Pingu207/ROCKET/FW/README.md

## About the Code

This is untested code, mostly boilerplate for now with init functions, and the start sequence in app_main(). State machine and all other files for the other components have not been worked on and will be typed in when the board arrives and testing is possible.

## AI

Help was taken from AI in the review process of the code, mostly for fixing issues with formatting, clarity, and error handling.
