Pingu207/ROCKET/Hardware Bill of Materials template - Sheet1.csv

Item Name | Qty | Price (total) (USD) | Item link | Notes
AeroTech G25W-10A RMS-29/120 Reload Kit (1 Pack) - 072510 | 5 | $206.58 | https://aerotech-rocketry.com/products/product_c968e0dc-44a1-0a42-42dc-d69b16336291 | This is our rocket motor we will be using for our TVC
5.38" Airframe Tubing 34" | 1 | $68.38 | https://locprecision.com/collections/rocket-components/products/cardboard-airframes?variant=39778656190655 | This is the body we are using but on the CAD it is a little smaller but it will be scaled up when printed
Fiberon™ PA6-GF25 | 2 | $59.98 | https://shop.polymaker.com/products/fiberon-pa6-gf25?variant=43596329582649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
Hitec HS-5055MG 9g Digital Metal Gear Micro Servo | 2 | $65.97 | https://motionrc.com/products/hitec-hs-5055mg-9g-digital-metal-gear-micro-servo-hrc35055s?gad_source=1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 | This is the servo we will be using for the TVC
Estes 12 Inch Model Rocket Parachute Orange/White 1 pc | 1 | $7.41 | https://www.acehardware.com/departments/home-and-decor/novelty-items/toys-and-games/9093761 | This will be the drouge parachute that comes out before the real one
Rip Stop Parachute | 1 | $20.92 | https://estesrockets.com/products/rip-stop-parachute?variant=51539308020017&country=US&currency=USD | This will be the main parachute
Total Price (USD): | $429.24
