Pingu207/ROCKET/PCB/electricalBOM.csv

JLCPCB BOM Tool - BOM Matching
BOM name：bom-JLCPCB Assembly Order.xlsx |  |  | Download Time：2026-10-25 23:32:35 |  |  |  | * Our matching results are updated in real-time, but stock and prices may change. If it's been over 24 hours, please re-match before placing your order.
PCB Assembled Qty：5 |  |  | Est. Total Price：278.1183
Your BOM |  |  |  | Matched Parts |  |  |  |  |  |  | Order Information
Designator | Comment | Footprint | JLCPCB Part # | Matches | Part # | Manufacturer | Footprint | Description | Category | Warning | JLCPCB Part # | Product link | Lib Type | Qty | Source | Total Price ($)
BZ1 | Buzzer | BUZ-TH_BD9.0-P4.00-D0.6-FD |  | Select by System | QMB-09B-03 | Jiangsu Huaneng Elec | 插件,D=9mm | -20℃~+70℃ 2.7kHz 2V~5V 3V 5.7mm 50mA 85dB 9mm Electromagnetic Passive (Externally Driven) 插件,D=9mm Buzzers ROHS | Buzzers |  | C96256 | https://jlcpcb.com/partdetail/Jiangsu_HuanengElec-QMB_09B03/C96256 | Extended | 6 | 6 JLCPCB | 0.708
C1,C12,C18,C23,C24,C26,C28,C3,C30,C33,C34,C35,C4,C5,C6,C8,C9 | 0.1uF | C0603 |  | Select by System | CT41G-0603-2X1-50V-0.1uF-K(N) | TORCH | 603 | 100nF 50V ±10% 0603 Multilayer Ceramic Capacitors MLCC - SMD/SMT ROHS | Multilayer Ceramic Capacitors MLCC - SMD/SMT |  | C125205 | https://jlcpcb.com/partdetail/TORCH-CT41G_0603_2X1_50V_0_1uF_K_N/C125205 | Extended | 91 | 91 JLCPCB | 0.9919
C10,C11,C16,C17,C2,C27,C29 | 10uF | C0805 |  | Select by System | GRM21BR61H106KE43L | Murata Electronics | 805 | 10uF 50V X5R ±10% 0805 Multilayer Ceramic Capacitors MLCC - SMD/SMT ROHS | Multilayer Ceramic Capacitors MLCC - SMD/SMT |  | C440198 | https://jlcpcb.com/partdetail/439567-GRM21BR61H106KE43L/C440198 | Basic | 37 | 37 JLCPCB | 7.6923
C13,C14,C15,C19,C20,C21,C31,C32 | 22uF | C0805 |  | Select by System | GRM21BR61E226ME44L | Murata Electronics | 805 | 22uF 25V X5R ±20% 0805 Multilayer Ceramic Capacitors MLCC - SMD/SMT ROHS | Multilayer Ceramic Capacitors MLCC - SMD/SMT |  | C86816 | https://jlcpcb.com/partdetail/MurataElectronics-GRM21BR61E226ME44L/C86816 | Extended | 44 | 44 JLCPCB | 10.5644
C22,C7 | 470uF | CAP-SMD_BD10.0-L10.3-W10.3-FD |  | Select by System | RVT1V471M1010 470UF 35V | DMBJ | SMD,D10xL10.2mm | -55℃~+105℃ 10.2mm 10mm 2800hrs@105℃ 35V 470uF ±20% SMD,D10xL10.2mm Aluminum Electrolytic Capacitors - SMD ROHS | Aluminum Electrolytic Capacitors - SMD |  | C976030 | https://jlcpcb.com/partdetail/DMBJ-RVT1V471M1010_470UF35V/C976030 | Extended | 10 | 10 JLCPCB | 0.909
D1,D2 | M7 | SMA_L4.3-W2.6-LS5.2-RD |  | Select by System | M7 | MDD(Microdiode Semiconductor) | SMA(DO-214AC) | -55℃~+150℃ 1.1V@1A 1A 1kV 30A 5uA@1kV Independent SMA(DO-214AC) Diodes - General Purpose ROHS | Diodes - General Purpose |  | C95872 | https://jlcpcb.com/partdetail/MDD_Microdiode_Semiconductor-M7/C95872 | Basic | 20 | 20 JLCPCB | 0.206
D3,D4,D5 | LED_Small | LED0603-FD |  | Select by System | YLED0603R | YONGYUTAI | 603 | -40℃~+85℃ 1.8V~2.4V 120mcd 120° 25mA 620nm~625nm Discrete Diode Red 0603 LED Indication - Discrete ROHS | LED Indication - Discrete |  | C19171390 | https://jlcpcb.com/partdetail/YONGYUTAI-YLED0603R/C19171390 | Extended | 31 | 31 JLCPCB | 0.1953
D6,D7 | D_Schottky_Small | SMC_L6.9-W5.9-LS7.9-RD |  | Unconfirmed | SS34 | onsemi | SMC(DO-214AB) | -55℃~+150℃ 1 Independent 100A 3A 40V 500mV@3A 500uA@40V SMC(DO-214AB) Schottky Diodes ROHS | Schottky Diodes | 1.Multiple lines in the BOM have been matched to the same part. Please check if the matching is correct. ; | C154551 | https://jlcpcb.com/partdetail/onsemi-SS34/C154551 | Extended | 15 | 15 JLCPCB | 7.1445
D8 | SS34 | SMC_L6.9-W5.9-LS7.9-RD |  | Unconfirmed
J1 | USB_C_Receptacle_USB2.0_14P | USB-C-TH_KH-TYPE-C-CY-14P |  | Select by System | KH-TYPE-C-CY-14P | Shenzhen Kinghelm Elec | 插件 | -40℃~+85℃ 1 10,000 cycles 14P 14mm 20V 3A Black Female Type-C Vertical, Flag 插件 USB Connectors ROHS | USB Connectors |  | C2919655 | https://jlcpcb.com/partdetail/3222637-KH_TYPE_C_CY14P/C2919655 | Extended | 5 | 5 JLCPCB | 2.7575
J2,J3,J4 | Conn_01x02_Socket | CONN-TH_2P-P2.00_HC-PH-2A-M |  | Select by System | WAFER-PH2.0-2PZZ | XUNPU | 插件,P=2mm | -25℃~+85℃ 1 1x2P 2 250V 2A 2P 2mm 4.7mm 6.05mm 6mm Brass PA66 PH Through Hole Tin UL94V-0 White 插件,P=2mm Wire To Board Connector ROHS | Wire To Board Connector |  | C5359599 | https://jlcpcb.com/partdetail/XUNPU-WAFER_PH2_02PZZ/C5359599 | Extended | 20 | 20 JLCPCB | 0.278
J5,J6 | Screw_Term_1x2 | CONN-TH_XY126V-5.0-2P |  | Select by System | XY126V-5.0-2P | Ningbo Xinlaiya Elec. | 插件,P=5mm | 1 10A 14~26 1x2P 2 2.5 2P 300V 5mm Green M2.5 Through Hole 插件,P=5mm Screw Terminal Blocks ROHS | Screw Terminal Blocks |  | C557646 | https://jlcpcb.com/partdetail/Ningbo_Xinlaiya_Elec-XY126V_5_02P/C557646 | Extended | 11 | 11 JLCPCB | 1.0659
J7 | Micro_SD_Card | TF-SMD_TF-115 |  | Select by System | TF-115 | XUNPU | SMD | 1.8mm Connector and Ejector MicroSD Card (TF Card) Push-Push SMD SD Card / Memory Card Connector ROHS | SD Card / Memory Card Connector |  | C266620 | https://jlcpcb.com/partdetail/XUNPU-TF115/C266620 | Extended | 6 | 6 JLCPCB | 1.0452
J8 | Conn_02x03_Odd_Even | HDR-TH_6P-P2.54-V-R2-C3-S2.54_A2541WV-2X3P |  | Select by System | 2.54-2*3 | ZHOURI | 插件,P=2.54mm | -40℃~+105℃ 2 2.54mm 2.54mm 2.54mm 2.5A 2x3P 3mm 6P 6mm Brass Gold Pin Header Through Hole 插件,P=2.54mm Pin Headers ROHS | Pin Headers |  | C5116479 | https://jlcpcb.com/partdetail/ZHOURI-2_54_23/C5116479 | Extended | 5 | 5 JLCPCB | 0.2995
L1,L2 | 3.3uH | IND-SMD_L4.4-W4.2-A |  | Select by System | FXL0420-3R3-M | cjiang (Changjiang Microelectronics Tech) | SMD,4.4x4.2mm | 3.3A 3.3uH 4A 87mΩ Molded inductor ±20% SMD,4.4x4.2mm Molding Power Inductors ROHS | Power Inductors |  | C167207 | https://jlcpcb.com/partdetail/178590-FXL0420_3R3M/C167207 | Extended | 12 | 12 JLCPCB | 1.6896
L3 | 3.9uH | IND-SMD_L5.0-W5.0 |  | Select by System | ZENR5040T3R9N-3.9uH | ZE | SMD,5x5mm | 27mΩ 3.2A 3.55A 3.9uH Magnetic Shielded Inductor ±30% SMD,5x5mm Power Inductors ROHS |  |  | C42428060 | https://jlcpcb.com/partdetail/ZE-ZENR5040T3R9N_39uH/C42428060 | Extended | 7 | 7 JLCPCB | 0.4424
Q1,Q2 | Q_NPN | SOT-23-3_L3.0-W1.7-P0.95-LS2.9-BR |  | Select by System | S8050 J3Y(RANGE:200-350) | Jiangsu Changjing Electronics Technology Co., Ltd. | SOT-23 | -55℃~+150℃ 1 NPN 100nA 150MHz 200 25V 300mW 500mA 5V 600mV NPN SOT-23 Bipolar (BJT) ROHS | Bipolar (BJT) |  | C2146 | https://jlcpcb.com/partdetail/2503-S8050_J3Y_RANGE_200_350/C2146 | Basic | 15 | 15 JLCPCB | 0.213
Q3,Q5 | IRLZ44N | TO-220-3_L10.0-W4.5-P2.54-T |  | Select by System | IRLZ44NPBF | Infineon Technologies | TO-220AB | -55℃~+175℃ 1 N-channel 1.7nF 110W 150pF 25mΩ@5V 2V 400pF 47A 48nC@5V 55V N-Channel TO-220AB MOSFETs ROHS | MOSFETs |  | C38774 | https://jlcpcb.com/partdetail/InfineonTechnologies-IRLZ44NPBF/C38774 | Extended | 10 | 10 JLCPCB | 7.185
Q4 | IRF7404 | SOIC-8_L4.9-W3.9-P1.27-LS6.0-BL |  | Select by System | IRF7404TRPBF | Infineon Technologies | SO-8 | -55℃~+150℃ 1 P-Channel 1.5nF 2.5W 20V 340pF 40mΩ@4.5V 50nC@4.5V 6.7A 700mV 730pF P-Channel SO-8 MOSFETs ROHS | MOSFETs |  | C2997 | https://jlcpcb.com/partdetail/InfineonTechnologies-IRF7404TRPBF/C2997 | Extended | 5 | 5 JLCPCB | 10.1055
Q6 | PN2222A | TO-92-3_L4.9-W3.7-P1.27-L |  | Select by System | 2N2222A | ST(Semtech) | TO-92 | 1 NPN 10nA 1V 250MHz 40 40V 600mA 625mW 6V NPN TO-92 Bipolar (BJT) ROHS | Bipolar (BJT) |  | C118536 | https://jlcpcb.com/partdetail/ST_Semtech-2N2222A/C118536 | Extended | 8 | 8 JLCPCB | 0.312
R1,R11,R15,R17,R19,R2,R20,R21,R27,R28,R3,R34,R35,R39,R40,R41,R8,R9 | 10k | R0603 |  | Select by System | RC0603FR-0710KL | YAGEO | 603 | -55℃~+155℃ 100mW 10kΩ 75V Thick Film Resistor ±1% ±100ppm/℃ 0603 Chip Resistor - Surface Mount ROHS | Chip Resistor - Surface Mount |  | C98220 | https://jlcpcb.com/partdetail/YAGEO-RC0603FR0710KL/C98220 | Extended | 100 | 100 JLCPCB | 0.27
R4 | 1k | R0603 |  | Select by System | RC0603FR-071KL | YAGEO | 603 | -55℃~+155℃ 100mW 1kΩ 75V Thick Film Resistor ±1% ±100ppm/℃ 0603 Chip Resistor - Surface Mount ROHS | Chip Resistor - Surface Mount |  | C22548 | https://jlcpcb.com/partdetail/YAGEO-RC0603FR071KL/C22548 | Extended | 20 | 20 JLCPCB | 0.072
R6,R7 | 5.1k | R0603 |  | Select by System | FRC0603F5101TS | FOJAN | 603 | -55℃~+155℃ 100mW 5.1kΩ 75V Thick Film Resistor ±1% ±100ppm/℃ 0603 Chip Resistor - Surface Mount ROHS | Chip Resistor - Surface Mount |  | C2907044 | https://jlcpcb.com/partdetail/FOJAN-FRC0603F5101TS/C2907044 | Extended | 20 | 20 JLCPCB | 0.038
R10,R14 | 100 | R0603 |  | Select by System | 0603WAF1000T5E | UNI-ROYAL(Uniroyal Elec) | 603 | -55℃~+155℃ 100mW 100Ω 75V Thick Film Resistor ±1% ±100ppm/℃ 0603 Chip Resistor - Surface Mount ROHS | Chip Resistor - Surface Mount |  | C22775 | https://jlcpcb.com/partdetail/23502-0603WAF1000T5E/C22775 | Basic | 20 | 20 JLCPCB | 0.046
R12,R13,R26,R30,R32,R33 | 4.7k | R0603 |  | Select by System | RC0603FR-074K7L | YAGEO | 603 | -55℃~+155℃ 100mW 4.7kΩ 75V Thick Film Resistor ±1% ±100ppm/℃ 0603 Chip Resistor - Surface Mount ROHS | Chip Resistor - Surface Mount |  | C99782 | https://jlcpcb.com/partdetail/YAGEO-RC0603FR074K7L/C99782 | Extended | 40 | 40 JLCPCB | 0.128
R16,R18 | 68.1k | R0603 |  | Select by System | 0603WAF6812T5E | UNI-ROYAL(Uniroyal Elec) | 603 | -55℃~+155℃ 100mW 68.1kΩ 75V Thick Film Resistor ±1% ±100ppm/℃ 0603 Chip Resistor - Surface Mount ROHS | Chip Resistor - Surface Mount |  | C25976 | https://jlcpcb.com/partdetail/26719-0603WAF6812T5E/C25976 | Extended | 20 | 20 JLCPCB | 0.04
R22,R23,R24,R25 | 150 | R0603 |  | Select by System | FRC0603F1500TS | FOJAN | 603 | -55℃~+155℃ 100mW 150Ω 75V Thick Film Resistor ±1% ±100ppm/℃ 0603 Chip Resistor - Surface Mount ROHS | Chip Resistor - Surface Mount |  | C2906994 | https://jlcpcb.com/partdetail/FOJAN-FRC0603F1500TS/C2906994 | Extended | 30 | 30 JLCPCB | 0.057
R31,R5 | 470 | R0603 |  | Select by System | 0603WAF4700T5E | UNI-ROYAL(Uniroyal Elec) | 603 | -55℃~+155℃ 100mW 470Ω 75V Thick Film Resistor ±1% ±100ppm/℃ 0603 Chip Resistor - Surface Mount ROHS | Chip Resistor - Surface Mount |  | C23179 | https://jlcpcb.com/partdetail/23906-0603WAF4700T5E/C23179 | Basic | 20 | 20 JLCPCB | 0.046
R36 | 33k | R0603 |  | Select by System | FRC0603F3302TS | FOJAN | 603 | -55℃~+155℃ 100mW 33kΩ 75V Thick Film Resistor ±1% ±100ppm/℃ 0603 Chip Resistor - Surface Mount ROHS | Chip Resistor - Surface Mount |  | C2907028 | https://jlcpcb.com/partdetail/FOJAN-FRC0603F3302TS/C2907028 | Extended | 20 | 20 JLCPCB | 0.04
R37 | 100k | R0603 |  | Select by System | RC0603FR-07100KL | YAGEO | 603 | -55℃~+155℃ 100kΩ 100mW 75V Thick Film Resistor ±1% ±100ppm/℃ 0603 Chip Resistor - Surface Mount ROHS | Chip Resistor - Surface Mount |  | C14675 | https://jlcpcb.com/partdetail/YAGEO-RC0603FR07100KL/C14675 | Extended | 20 | 20 JLCPCB | 0.046
R38 | 0 | R0603 |  | Select by System | RC0603JR-070RL | YAGEO | 603 | -55℃~+155℃ 0Ω 100mW 75V Thick Film Resistor ±5% 0603 Chip Resistor - Surface Mount ROHS | Chip Resistor - Surface Mount |  | C95177 | https://jlcpcb.com/partdetail/YAGEO-RC0603JR070RL/C95177 | Extended | 20 | 20 JLCPCB | 0.042
R42 | 330 | R0603 |  | Select by System | RC0603FR-07330RL | YAGEO | 603 | -55℃~+155℃ 100mW 330Ω 75V Thick Film Resistor ±1% ±100ppm/℃ 0603 Chip Resistor - Surface Mount ROHS | Chip Resistor - Surface Mount |  | C105881 | https://jlcpcb.com/partdetail/YAGEO-RC0603FR07330RL/C105881 | Extended | 20 | 20 JLCPCB | 0.09
SW1,SW2 | Tactile | SW-SMD_L3.9-W3.0-P4.45 |  | Select by System | TS-1088-AR02016 | XUNPU | SMD,4x3mm | -30℃~+80℃ 1.6N 100,000 cycles 12V 2mm 3.9mm 3mm 50mA Black Round Button SMD(SMT) Tab SPST Surface Mount,Vertical Without Bracket SMD,4x3mm Tactile Switches ROHS | Tactile Switches |  | C720477 | https://jlcpcb.com/partdetail/XUNPU-TS_1088AR02016/C720477 | Basic | 14 | 14 JLCPCB | 0.7378
U1 | ESPWROOM32 | WIFIM-SMD_ESP32-WROOM-32-N4 |  | Select by System | ESP32-WROOM-32-N4 | Espressif Systems | SMD,25.5x18mm | -40℃~+85℃ -98dBm 2.4GHz 2.7V~3.6V 20dBm Bluetooth4.2 ESP32-DOWDQ6 UART、SDIO、SPI、I2C、GPIO、PWM、ADC、DAC SMD,25.5x18mm WiFi Modules ROHS | WiFi Modules |  | C82899 | https://jlcpcb.com/partdetail/EspressifSystems-ESP32_WROOM_32N4/C82899 | Extended | 5 | 5 JLCPCB | 22.289
U2 | ICM-42688-P | LGA-14_L3.0-W2.5-P0.50-TL |  | Select by System | ICM-42688-P | TDK InvenSense | LGA-14(2.5x3) | -40℃~+85℃ 1.71V~3.6V 16bit 2KB 7.5uA IMU (accelerometer + gyroscope) SPI、I2C X,Y,Z X,Y,Z ±16g ±2000dps Motion Event Detection, Synchronization, Timestamp Support LGA-14(2.5x3) Accelerometers ROHS | Accelerometers |  | C1850418 | https://jlcpcb.com/partdetail/TDKInvenSense-ICM_42688P/C1850418 | Extended | 5 | 5 JLCPCB | 107.6485
U3 | CH340K | ESOP-10_L4.9-W3.9-P1.00-LS6.2-BL-EP |  | Select by Customer | CH340K | WCH(Jiangsu Qin Heng) | ESSOP-10-150mil-1mm | -20℃~+70℃ 2Mbps 3.3V、5V USB 2.0 USB to serial ESSOP-10-150mil-1mm USB Converters ROHS | USB Converters |  | C18208922 | https://jlcpcb.com/partdetail/WCH_Jiangsu_Qin_Heng-CH340K/C18208922 | Extended | 5 | 5 JLCPCB | 3.314
U4 | USBLC6-2SC6 | SOT-23-6_L2.9-W1.6-P0.95-LS2.8-BL |  | Select by System | USBLC6-2SC6 | STMicroelectronics | SOT-23-6L | -40℃~+125℃ 150nA 17V 2 3.5pF 5.25V 5A 6V ESD IEC 61000-4-2 Unidirectional SOT-23-6L ESD and Surge Protection (TVS/ESD) ROHS | ESD And Surge Protection (TVS/ESD) |  | C7519 | https://jlcpcb.com/partdetail/STMicroelectronics-USBLC62SC6/C7519 | Extended | 7 | 7 JLCPCB | 1.2579
U6 | AP63203WU | TSOT-26_L2.9-W1.6-P0.95-LS2.8-BL |  | Select by System | AP63203WU-7 | Diodes Incorporated | TSOT-23-6 | -40℃~+85℃@(TA) 1 1.1MHz 22uA 2A 3.3V 3.8V~32V Buck Built-in Fixed Overcurrent Protection、Light load efficient mode、Cycle-by-cycle current limiting、Hiccup current limiting、EMI optimization (spread spectrum) Step-down type Yes TSOT-23-6 DC-DC Converters ROHS | DC-DC Converters |  | C780769 | https://jlcpcb.com/partdetail/DiodesIncorporated-AP63203WU7/C780769 | Extended | 5 | 5 JLCPCB | 6.1205
U7,U8 | PC817 | DIP-4_L6.4-W4.6-P2.54-LS7.6-BL |  | Select by System | PC817X2NSZW | Sharp Microelectronics | DIP-4 | -30℃~+100℃ 1.2V 100mV@20mA,1mA 200mW 3us 4us 50mA 50mA 5kV 6V 80V DC DIP-4 Transistor, Photovoltaic Output Optoisolators ROHS | Transistor, Photovoltaic Output Optoisolators |  | C5350 | https://jlcpcb.com/partdetail/SharpMicroelectronics-PC817X2NSZW/C5350 | Extended | 11 | 11 JLCPCB | 0.8591
U10,U9 | TPS563200 | TSOT-26_L2.9-W1.6-P0.95-LS2.8-BL |  | Select by System | TPS563200DDCR | Texas Instruments | TSOT-23-6 | -40℃~+85℃@(TA) 1 3A 4.5V~17V 650kHz 760mV~7V Adjustable Buck Buck Built-in Yes TSOT-23-6 DC-DC Converters ROHS | DC-DC Converters |  | C97253 | https://jlcpcb.com/partdetail/TexasInstruments-TPS563200DDCR/C97253 | Extended | 10 | 10 JLCPCB | 8.739
U5 | BMP280 | LGA-8_L2.5-W2.0-P0.65_AMP6127 |  | Select by System | BMP280 | Bosch Sensortec | LGA-8 | -40℃~+85℃ 0.12hpa 1.5pa/K 1.71V~3.6V 1hpa 300nA 30Kpa~1.1bar I2C、SPI LGA-8(2x2.5) Pressure Sensors ROHS | Pressure Sensors |  | C83291 | https://jlcpcb.com/partdetail/BoschSensortec-BMP280/C83291 | Extended | 5 | 5 JLCPCB | 65.288
TOTAL PARTS COST |  | >>> | >>> | >>> | >>> | >>> | >>> | >>> | >>> | >>> | >>> | >>> | >>> | >>> | >>> | $270.97
Other | PCB Cost | >>> | >>> | >>> | >>> | >>> | >>> | >>> | >>> | >>> | >>> | >>> | >>> | >>> | >>> | $8.00
Other | PCBA Cost | >>> | >>> | >>> | >>> | >>> | >>> | >>> | >>> | >>> | >>> | >>> | >>> | >>> | >>> | $37.97
TOTAL OTHERS COST |  | >>> | >>> | >>> | >>> | >>> | >>> | >>> | >>> | >>> | >>> | >>> | >>> | >>> | >>> | $45.97
Total Cost | >>> | >>> | >>> | >>> | >>> | >>> | >>> | >>> | >>> | >>> | >>> | >>> | >>> | >>> | >>> | $316.94
