Pingu207/ROCKET/CAD/CONE.step

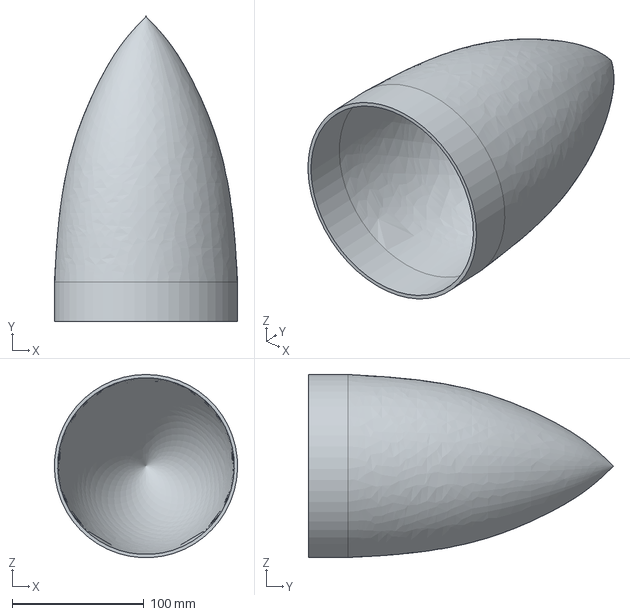
[picture p1: CAD file, 2026-10-26]
CAD/CONE.step
138.9 x 231.4 x 138.9 mm
