Pingu207/ROCKET/CAD/PCB_HOLDER.step

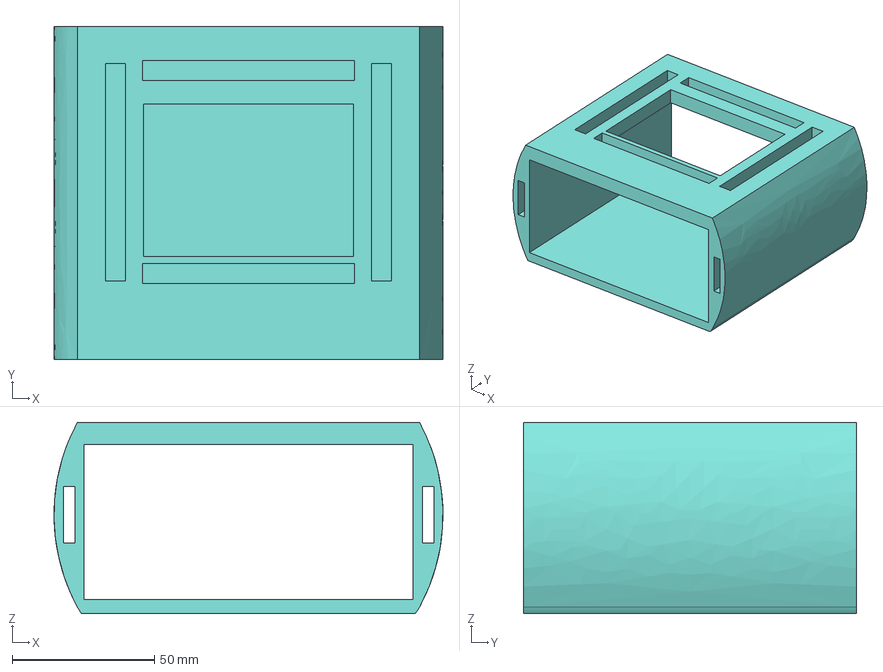
[picture p2: CAD file, 2026-10-26]
CAD/PCB_HOLDER.step
136.7 x 117.0 x 67.1 mm
