Pingu207/ROCKET/CAD/ROCKET_BODY.step

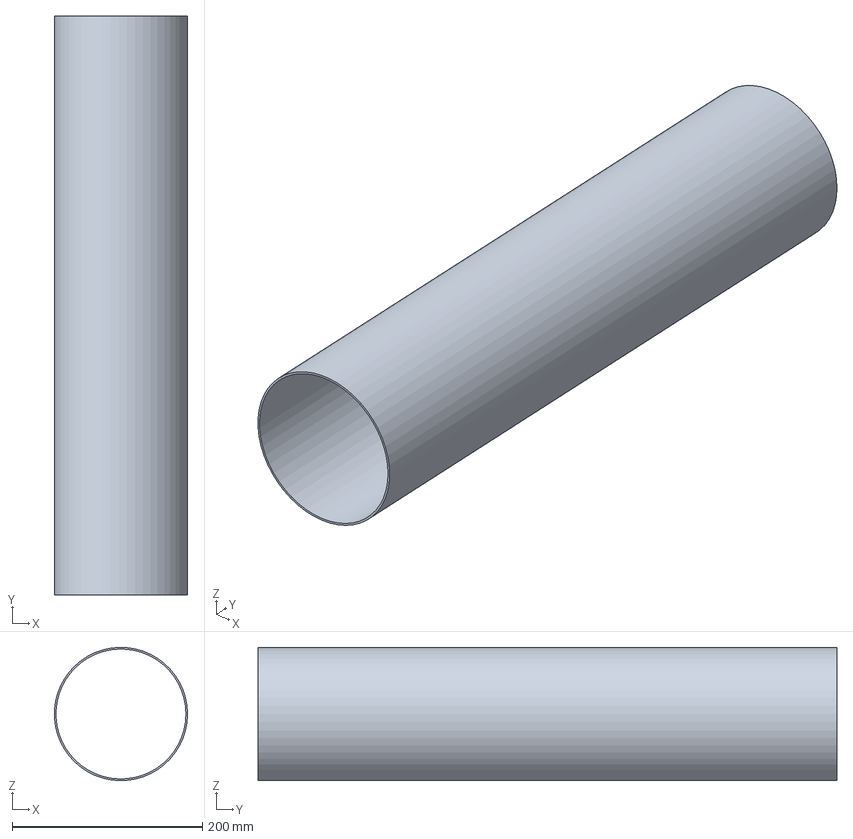
[picture p3: CAD file, 2026-10-26]
CAD/ROCKET_BODY.step
140.0 x 609.0 x 140.1 mm
