Pingu207/ROCKET/CAD/TVC_MOUNT.step

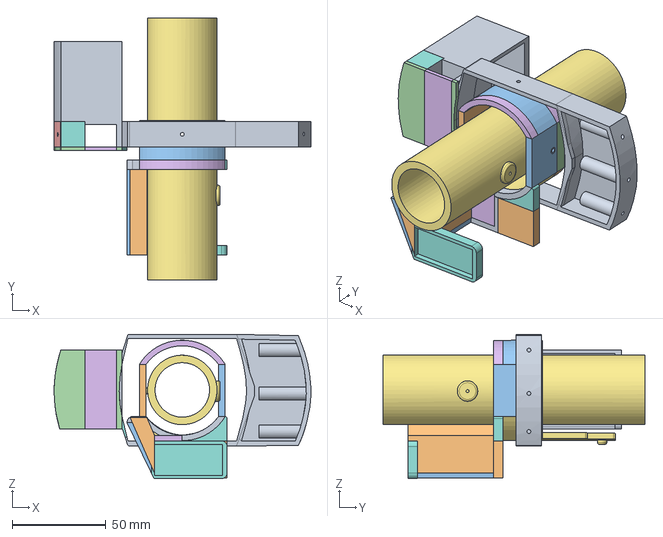
[picture p4: CAD file, 2026-10-26]
CAD/TVC_MOUNT.step
136.9 x 139.5 x 76.8 mm
