Pingu207/ROCKET/PCB/Rocket.kicad_pcb

## KiCad design PCB/Rocket.kicad_pcb (2026-10-25)

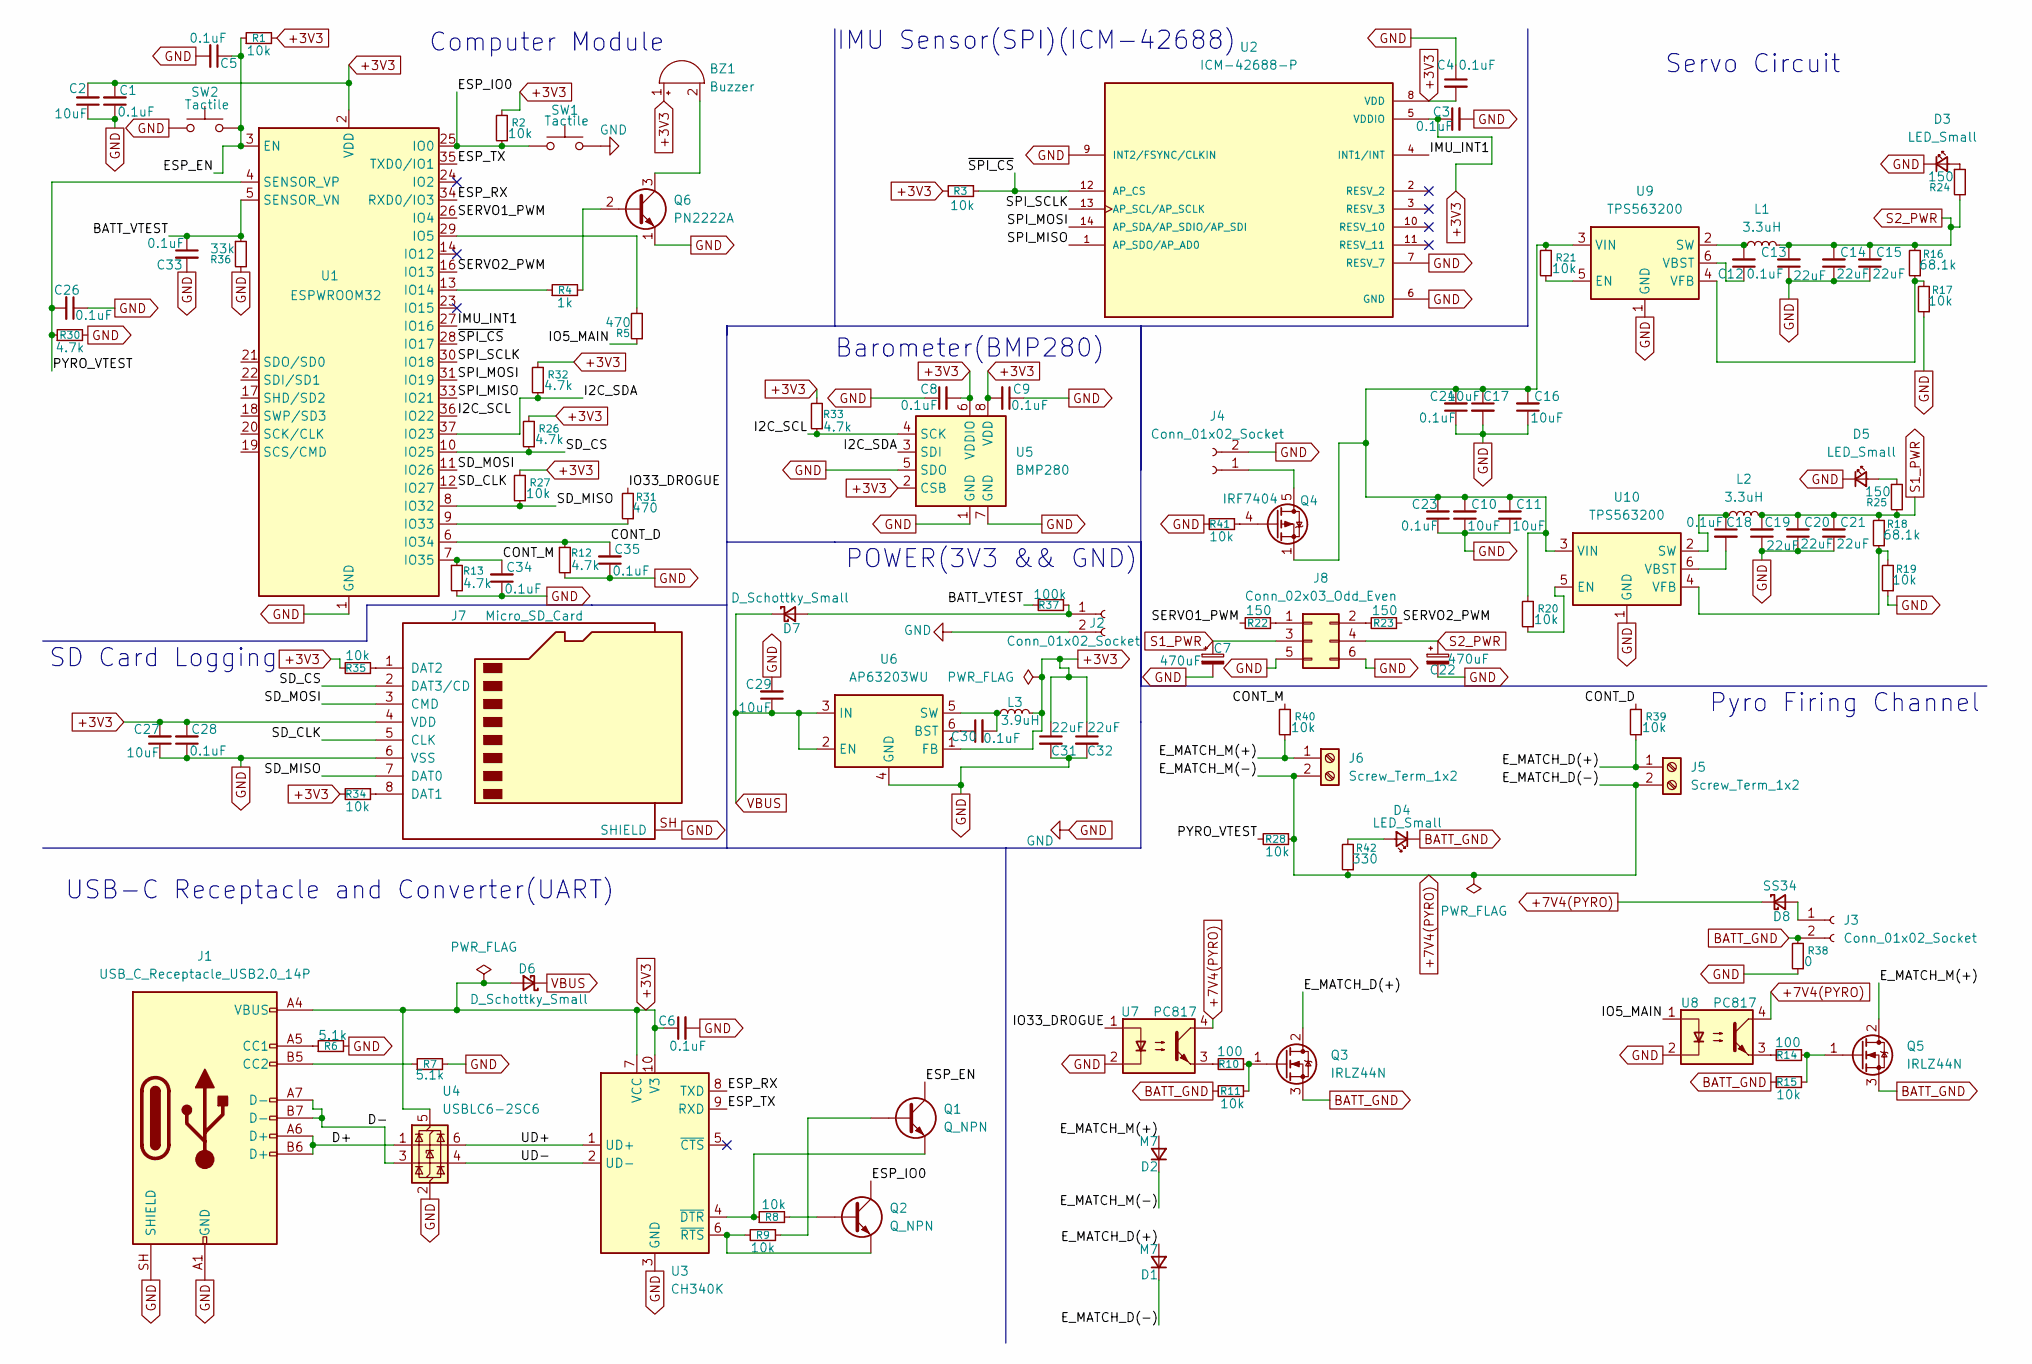
[picture p5: schematic Rocket.kicad_sch, Flight Computer for TVC Rocket Schematic]

Parts:
BZ1: Buzzer; BUZ-TH_BD9.0-P4.00-D0.6-FD; LCSC C96256
C1, C3, C4, C5, C6, C8, C9, C12, C18, C23, C24, C26, C28, C30, C33, C34, C35: 0.1uF; C0603; LCSC C125205
C2, C10, C11, C16, C17, C27, C29: 10uF; C0805; LCSC C440198
C7, C22: 470uF; CAP-SMD_BD10.0-L10.3-W10.3-FD; LCSC C976030
C13, C14, C15, C19, C20, C21, C31, C32: 22uF; C0805; LCSC C86816
D1, D2: M7; SMA_L4.3-W2.6-LS5.2-RD; LCSC C95872
D3, D4, D5: LED_Small; LED0603-FD; LCSC C19171390
D6, D7: D_Schottky_Small; SMC_L6.9-W5.9-LS7.9-RD; LCSC C154551
D8: SS34; SMC_L6.9-W5.9-LS7.9-RD; LCSC C154551
J1: USB_C_Receptacle_USB2.0_14P; USB-C-TH_KH-TYPE-C-CY-14P; LCSC C2919655
J2, J3, J4: Conn_01x02_Socket; CONN-TH_2P-P2.00_HC-PH-2A-M; LCSC C5359599
J5, J6: Screw_Term_1x2; CONN-TH_XY126V-5.0-2P; LCSC C557646
J7: Micro_SD_Card; TF-SMD_TF-115; LCSC C266620
J8: Conn_02x03_Odd_Even; HDR-TH_6P-P2.54-V-R2-C3-S2.54_A2541WV-2X3P; LCSC C5116479
L1, L2: 3.3uH; IND-SMD_L4.4-W4.2-A; LCSC C167207
L3: 3.9uH; IND-SMD_L5.0-W5.0; LCSC C42428060
Q1, Q2: Q_NPN; SOT-23-3_L3.0-W1.7-P0.95-LS2.9-BR; LCSC C2146
Q3, Q5: IRLZ44N; TO-220-3_L10.0-W4.5-P2.54-T; LCSC C38774
Q4: IRF7404; SOIC-8_L4.9-W3.9-P1.27-LS6.0-BL; LCSC C2997
Q6: PN2222A; TO-92-3_L4.9-W3.7-P1.27-L; LCSC C118536
R1, R2, R3, R8, R9, R11, R15, R17, R19, R20, R21, R27, R28, R34, R35, R39, R40, R41: 10k; R0603; LCSC C98220
R4: 1k; R0603; LCSC C22548
R5, R31: 470; R0603; LCSC C23179
R6, R7: 5.1k; R0603; LCSC C2907044
R10, R14: 100; R0603; LCSC C22775
R12, R13, R26, R30, R32, R33: 4.7k; R0603; LCSC C99782
R16, R18: 68.1k; R0603; LCSC C25976
R22, R23, R24, R25: 150; R0603; LCSC C2906994
R36: 33k; R0603; LCSC C2907028
R37: 100k; R0603; LCSC C14675
R38: 0; R0603; LCSC C95177
R42: 330; R0603; LCSC C105881
SW1, SW2: Tactile; SW-SMD_L3.9-W3.0-P4.45; LCSC C720477
U1: ESPWROOM32; WIFIM-SMD_ESP32-WROOM-32-N4; LCSC C82899
U2: ICM-42688-P; LGA-14_L3.0-W2.5-P0.50-TL; PARTREV 1.2; LCSC C1850418
U3: CH340K; ESOP-10_L4.9-W3.9-P1.00-LS6.2-BL-EP; LCSC C968586
U4: USBLC6-2SC6; SOT-23-6_L2.9-W1.6-P0.95-LS2.8-BL; LCSC C7519
U5: BMP280; LGA-8_L2.5-W2.0-P0.65_AMP6127; LCSC C83291
U6: AP63203WU; TSOT-26_L2.9-W1.6-P0.95-LS2.8-BL; LCSC C780769
U7, U8: PC817; DIP-4_L6.4-W4.6-P2.54-LS7.6-BL; LCSC C5350
U9, U10: TPS563200; TSOT-26_L2.9-W1.6-P0.95-LS2.8-BL; LCSC C97253

Connections:
+3V3: BZ1.1 (+), C1.2, C2.2, C3.1, C4.2, C6.1, C8.2, C9.2, C27.2, C28.2, C31.1, C32.1, D6.2 (A), J1.A4 (VBUS), J1.A9 (VBUS), J1.B4 (VBUS), J1.B9 (VBUS), J7.4 (VDD), L3.2, R1.2, R2.2, R3.2, R26.2, R27.2, R32.2, R33.2, R34.2, R35.2, U1.2 (VDD), U2.5 (VDDIO), U2.8 (VDD), U3.7 (VCC), U3.10 (V3), U4.5 (VBUS), U5.2 (CSB), U5.6 (VDDIO), U5.8 (VDD), U6.1 (FB)
+7V4(PYRO): D1.1 (K), D2.1 (K), D8.1 (K), J5.2, J6.2, R28.1, R42.1, U7.4, U8.4
/BATT_VTEST: C33.1, R36.1, R37.2, U1.5 (SENSOR_VN)
/CONT_D: C35.2, R12.1, R39.2, U1.6 (IO34)
/CONT_M: C34.2, R13.1, R40.2, U1.7 (IO35)
/D+: J1.A6 (D+), J1.B6 (D+), U4.1 (I/O1)
/D-: J1.A7 (D-), J1.B7 (D-), U4.3 (I/O2)
/ESP_EN: C5.1, Q1.3, R1.1, SW2.2, U1.3 (EN)
/ESP_IO0: Q2.3, R2.1, SW1.1, U1.25 (IO0)
/ESP_RX: U1.34 (RXD0/IO3), U3.8 (TXD)
/ESP_TX: U1.35 (TXD0/IO1), U3.9 (RXD)
/E_MATCH_D(+): D1.2 (A), J5.1, Q3.2 (D), R39.1
/E_MATCH_M(+): D2.2 (A), J6.1, Q5.2 (D), R40.1
/I2C_SCL: R33.1, U1.36 (IO22), U5.4 (SCK)
/I2C_SDA: R32.1, U1.37 (IO23), U5.3 (SDI)
/IMU_INT1: U1.27 (IO16), U2.4 (INT1/INT)
/IO5_MAIN: R5.1, U8.1
/IO33_DROGUE: R31.2, U7.1
/PYRO_VTEST: C26.2, R28.2, R30.1, U1.4 (SENSOR_VP)
/SD_CLK: J7.5 (CLK), U1.12 (IO27)
/SD_CS: J7.2 (DAT3/CD), R26.1, U1.10 (IO25)
/SD_MISO: J7.7 (DAT0), R27.1, U1.8 (IO32)
/SD_MOSI: J7.3 (CMD), U1.11 (IO26)
/SERVO1_PWM: R22.2, U1.26 (IO4)
/SERVO2_PWM: R23.1, U1.16 (IO13)
/SPI_MISO: U1.33 (IO21), U2.1 (AP_SDO/AP_AD0)
/SPI_MOSI: U1.31 (IO19), U2.14 (AP_SDA/AP_SDIO/AP_SDI)
/SPI_SCLK: U1.30 (IO18), U2.13 (AP_SCL/AP_SCLK)
/UD+: U3.1 (UD+), U4.6 (I/O1)
/UD-: U3.2 (UD-), U4.4 (I/O2)
/~SPI_CS: R3.1, U1.28 (IO17), U2.12 (AP_CS)
BATT_GND: D4.1 (K), J3.2, Q3.3 (S), Q5.3 (S), R11.2, R15.2, R38.2
GND: C1.1, C2.1, C3.2, C4.1, C5.2, C6.2, C7.2, C8.1, C9.1, C10.1, C11.1, C13.1, C14.1, C15.1, C16.1, C17.2, C19.1, C20.1, C21.1, C22.2, C23.1, C24.1, C26.1, C27.1, C28.1, C29.2, C31.2, C32.2, C33.2, C34.1, C35.1, D3.1 (K), D5.1 (K), J1.A1 (GND), J1.A12 (GND), J1.B1 (GND), J1.B12 (GND), J1.SH (SHIELD), J2.2, J4.2, J7.6 (VSS), J7.SH (SHIELD), J8.5, J8.6, Q6.1 (E), R6.2, R7.2, R12.2, R13.2, R17.1, R19.1, R30.2, R36.2, R38.1, R41.2, SW1.2, SW2.1, U1.1 (GND), U1.15 (GND), U1.38 (GND), U1.39 (GND), U2.6 (GND), U2.7 (RESV_7), U2.9 (INT2/FSYNC/CLKIN), U3.3 (GND), U3.11 (GND), U4.2 (GND), U5.1 (GND), U5.5 (SDO), U5.7 (GND), U6.4 (GND), U7.2, U8.2, U9.1 (GND), U10.1 (GND)
unnamed: BZ1.2 (-), Q6.3 (C)
unnamed: D3.2 (A), R24.1
unnamed: D4.2 (A), R42.2
unnamed: D5.2 (A), R25.1
unnamed: D7.2 (A), J2.1, R37.1
unnamed: D8.2 (A), J3.1
unnamed: J1.A5 (CC1), R6.1
unnamed: J1.B5 (CC2), R7.1
unnamed: J4.1, Q4.5 (D), Q4.6 (D), Q4.7 (D), Q4.8 (D)
unnamed: J7.8 (DAT1), R34.1
unnamed: J7.1 (DAT2), R35.1
unnamed: J8.1, R22.1
unnamed: J8.2, R23.2
unnamed: Q1.1, R9.1
unnamed: Q2.1, R8.2
unnamed: Q3.1 (G), R10.1, R11.1
unnamed: Q4.4 (G), R41.1
unnamed: Q5.1 (G), R14.1, R15.1
unnamed: Q6.2 (B), R4.2
unnamed: R10.2, U7.3
unnamed: R14.2, U8.3
unnamed: R5.2, U1.29 (IO5)
unnamed: R4.1, U1.13 (IO14)
unnamed: R31.1, U1.9 (IO33)
unnamed: Q1.2, R8.1, U3.4 (~DTR)
unnamed: Q2.2, R9.2, U3.6 (~RTS)
unnamed: C30.1, U6.6 (BST)
unnamed: C30.2, L3.1, U6.5 (SW)
unnamed: R21.1, U9.5 (EN)
unnamed: C12.2, L1.1, U9.2 (SW)
unnamed: C12.1, U9.6 (VBST)
unnamed: R16.1, R17.2, U9.4 (VFB)
unnamed: R20.1, U10.5 (EN)
unnamed: C18.1, L2.1, U10.2 (SW)
unnamed: C18.2, U10.6 (VBST)
unnamed: R18.1, R19.2, U10.4 (VFB)
unnamed: C10.2, C11.2, C16.2, C17.1, C23.2, C24.2, Q4.1 (S), Q4.2 (S), Q4.3 (S), R20.2, R21.2, U9.3 (VIN), U10.3 (VIN)
S1_PWR: C7.1, C19.2, C20.2, C21.2, J8.3, L2.2, R18.2, R25.2
S2_PWR: C13.2, C14.2, C15.2, C22.1, J8.4, L1.2, R16.2, R24.2
VBUS: C29.1, D6.1 (K), D7.1 (K), U6.2 (EN), U6.3 (IN)

Notes on the sheet:
IMU Sensor(SPI)(ICM-42688)
SD Card Logging
Servo Circuit
Computer Module
Pyro Firing Channel
USB-C Receptacle and Converter(UART)
Barometer(BMP280)
POWER(3V3 && GND)

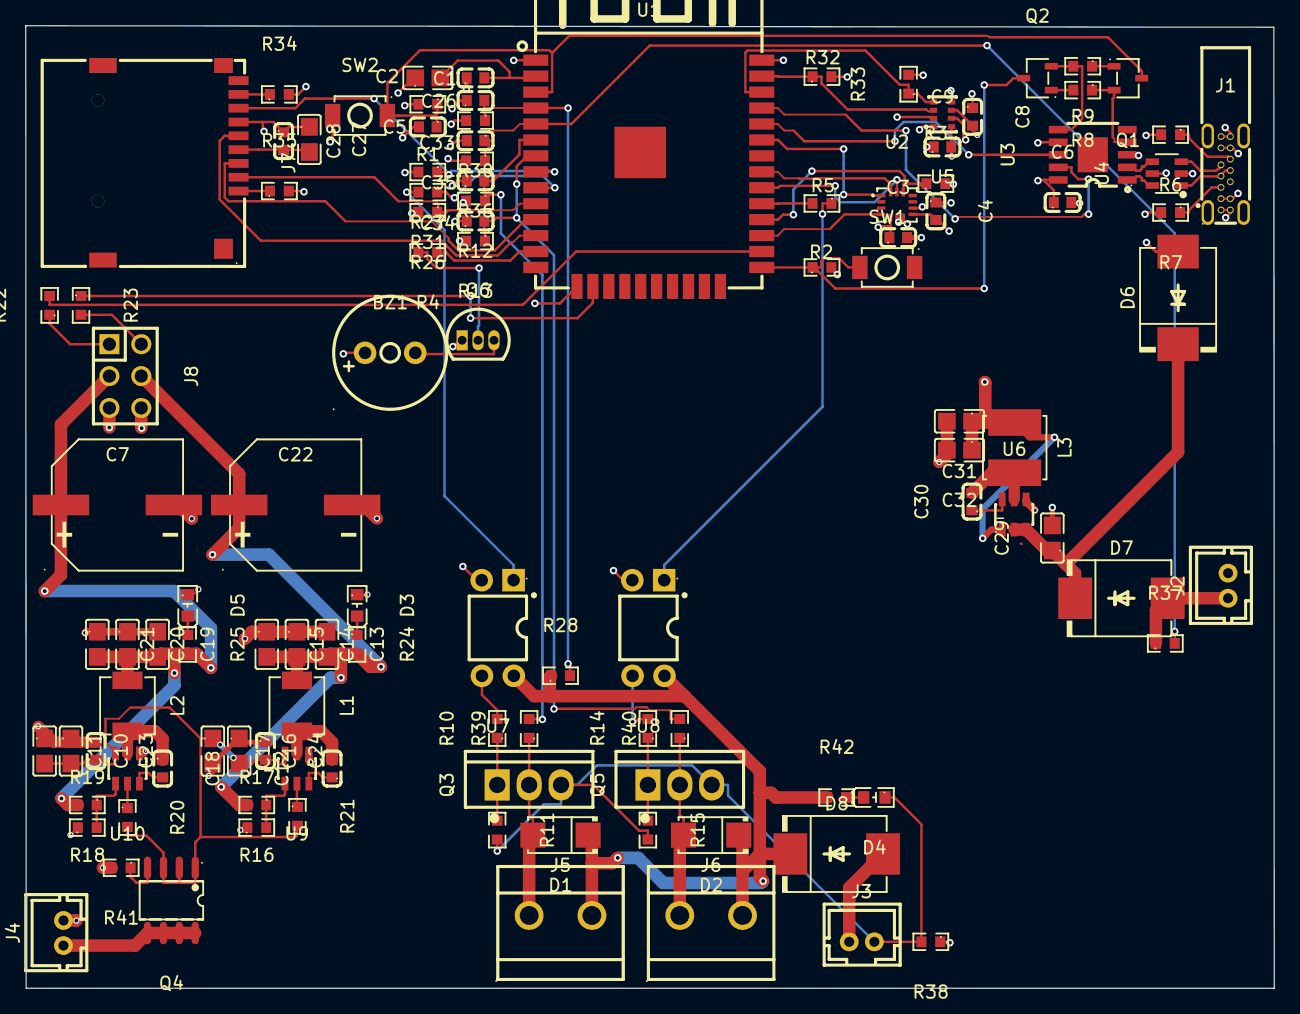
[picture p6: board Rocket.kicad_pcb from above]

Board: 4 copper layers, 99.5 x 76.7 mm, 113 parts (0 on the bottom side), 73 nets.
