Pingu207/ROCKET/(commit log)

2026-10-25 Added Gerbers
2026-10-25 Added Schematic
    [Rocket.kicad_sch]
2026-10-25 Added .kicad_pcb file
    [Rocket.kicad_pcb]
2026-10-25 Refine PCB README with updated specifications
    Updated actuation, programming, and board details for clarity. Revised connector descriptions for better understanding.
2026-10-25 Revise Rocket Flight Computer README for clarity
    Updated the README to provide a clearer overview of the Rocket Flight Computer's functionality, design, and assembly instructions. Removed outdated sections and added safety notes and known issues for better clarity.
2026-10-26 Add Hardware Bill of Materials template
2026-10-26 Add Barometer subsystem details to README
    Added a new Barometer subsystem section detailing the BMP280 usage and wiring.
2026-10-26 Update Rocket PCB README with subsystem details
    Expanded the Computer Module Subsystem description and added a new Logic Power and GND subsystem section detailing its components and functionality.
2026-10-26 Enhance USB and Logic Power subsystem descriptions
    Added details about VBUS power and buck converter configuration to the USB Input and Logic Power subsystems.
2026-10-26 Add Hardware BOM for project components
    Added a comprehensive hardware bill of materials (BOM) for the project, including item names, quantities, prices, links, and notes.
2026-10-28 Found correct include statements
    [main.c]
2026-10-28 Added pin definitions
2026-10-28 Wrote function prototypes
2026-10-28 Wrote state switch
2026-10-29 Wrote in timer and channel configs for servo
2026-10-29 Wrote channel config for yaw servo
2026-10-29 finished up servo_init() function
2026-10-30 Wrote SPI bus config code
2026-10-30 wrote in spi bus add device code
2026-10-30 wrote in i2c master bus declarations
2026-10-30 Refactor initialization functions and improve error handling for SPI and I2C subsystems
    [main.c]
2026-10-30 Implement SD card initialization and configure SPI bus settings
2026-10-30 Fix SD_MOUNT definition and enhance SD card initialization with error handling
    [main.c]
2026-10-30 Refactor error handling in initialization functions for SPI, I2C, and SD card
    [main.c]
2026-10-30 Refactor initialization functions to use static configurations for SPI, I2C, and SD card
2026-10-30 Refactor pin definitions and initialization configurations for clarity and consistency
2026-10-30 Add missing includes for I2C and SPI drivers in main.c
    [main.c]
2026-10-30 Refactor static variable declarations and add SERVO_CENTER_DUTY definition for clarity
2026-10-30 changed lines in imu_init with help from AI review
2026-10-30 Refactor barometer initialization for clarity and correct I2C bus handling
    [main.c]
2026-10-30 Refactor servo initialization for clarity and improve error logging; took suggestions from VSCode AI assistant
    [main.c]
2026-10-30 Finished code for this revision, will add more after board arrives
2026-10-30 Update Rocket PCB README with new subsystems and details
    Added new subsystems for SD card logging, servo power, and pyro firing. Enhanced descriptions for existing subsystems.
2026-10-31 Rename CAD ReadMe.txt to README.md
